romkk/TriDrone/doc/brushless_ctrl/umbauanleitung 18A sommer 2008/hinten.JPG

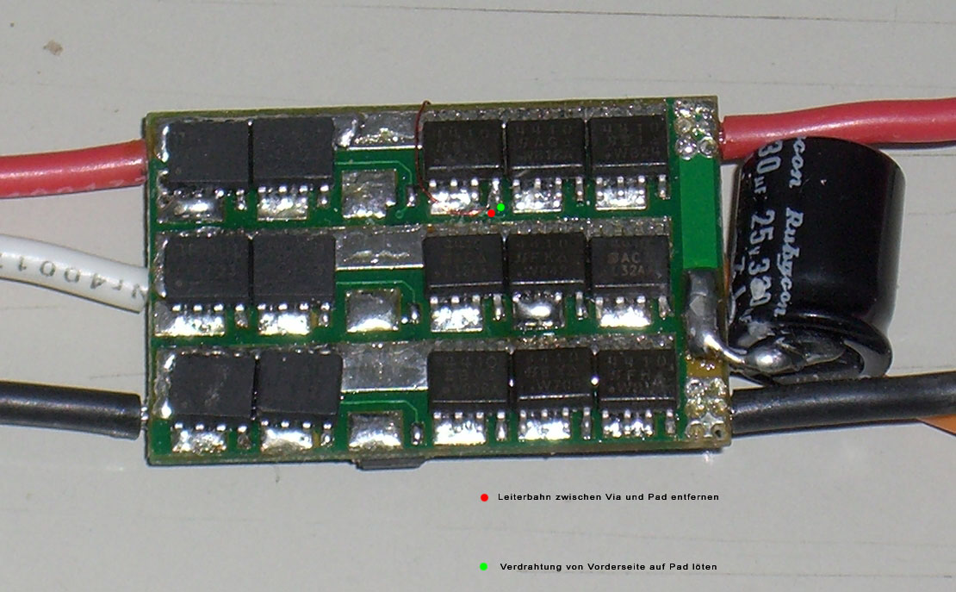
doc/brushless_ctrl/umbauanleitung 18A sommer 2008/hinten.JPG
