romkk/TriDrone/README.md

## About

Firmware and software collection of project "TriDrone".
It is a micro-copter project.
