romkk/TriDrone/doc/cockpit_mockup/telemetry_placeholder.jpg

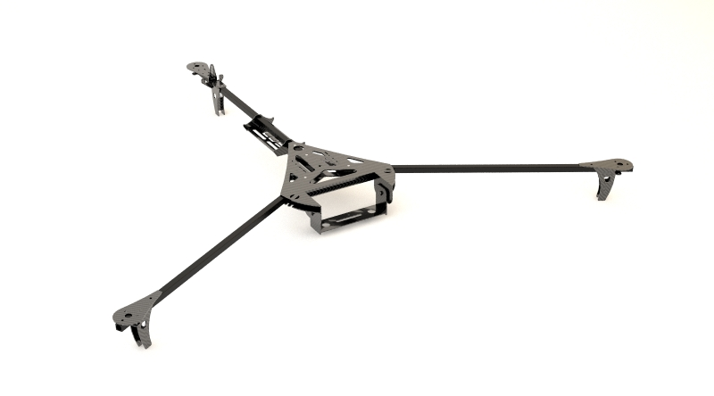
doc/cockpit_mockup/telemetry_placeholder.jpg
