romkk/TriDrone/doc/connectivity/img/ADXL322.jpeg

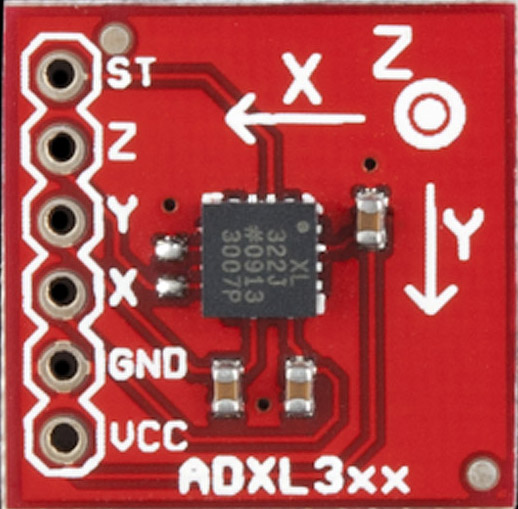
doc/connectivity/img/ADXL322.jpeg
