romkk/TriDrone/doc/connectivity/img/ArduinoProMini.jpg

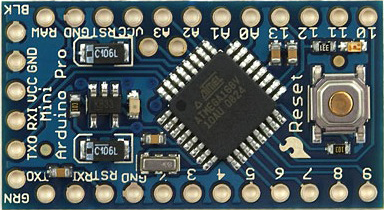
doc/connectivity/img/ArduinoProMini.jpg
