romkk/TriDrone/doc/connectivity/img/BL-Ctrl2_0.jpeg

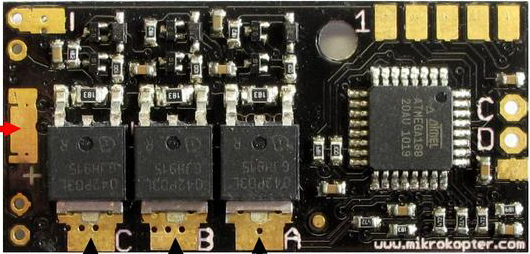
doc/connectivity/img/BL-Ctrl2_0.jpeg
