romkk/TriDrone/doc/connectivity/img/BMS-371.jpg

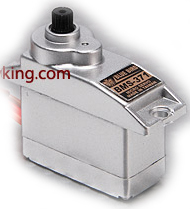
doc/connectivity/img/BMS-371.jpg
