romkk/TriDrone/doc/connectivity/img/ftdi_basic_breakout.jpg

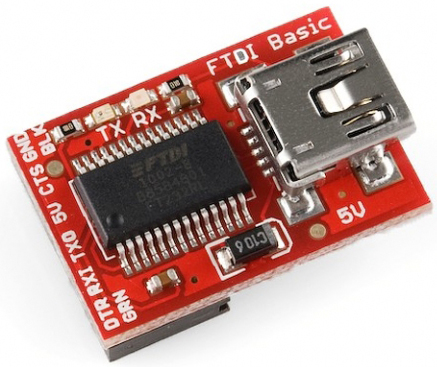
doc/connectivity/img/ftdi_basic_breakout.jpg
