romkk/TriDrone/doc/connectivity/img/Gyro_Breakout_Board_ADXRS610_300°_s.jpg

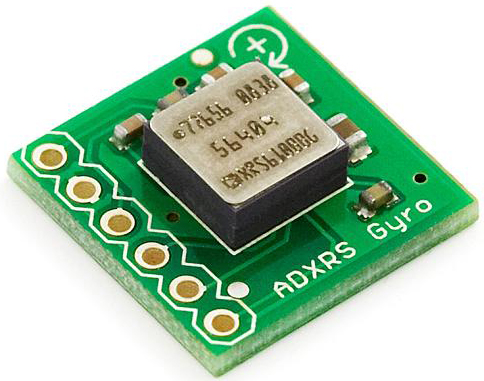
doc/connectivity/img/Gyro_Breakout_Board_ADXRS610_300°_s.jpg
