romkk/TriDrone/doc/connectivity/img/rockamp_2200mAh_3S_24.4Wh_30C.jpg

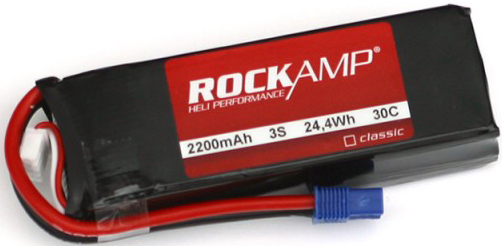
doc/connectivity/img/rockamp_2200mAh_3S_24.4Wh_30C.jpg
