romkk/TriDrone/doc/connectivity/img/SP_SII_2212_885.jpg

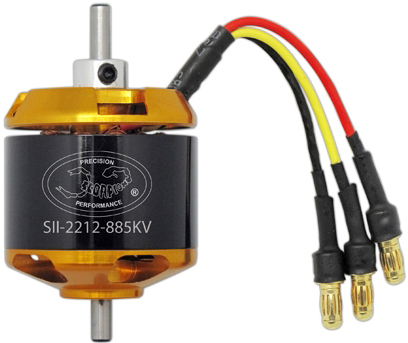
doc/connectivity/img/SP_SII_2212_885.jpg
