romkk/TriDrone/doc/connectivity/img/u_blox_module.jpg

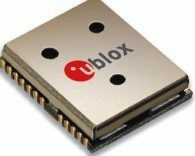
doc/connectivity/img/u_blox_module.jpg
