romkk/TriDrone/doc/connectivity/img/XBee Adapter Kit.jpg

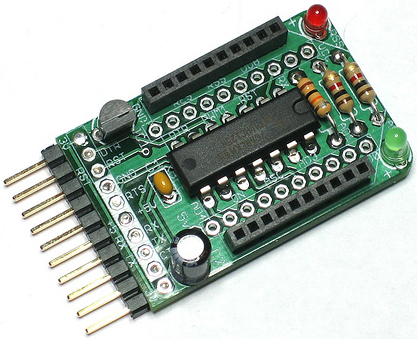
doc/connectivity/img/XBee Adapter Kit.jpg
