romkk/TriDrone/doc/connectivity/img/Xbee_series_2.jpg

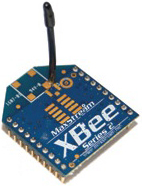
doc/connectivity/img/Xbee_series_2.jpg
