romkk/TriDrone/sch/Belichtungsreihe/Belichtungsreihe.png

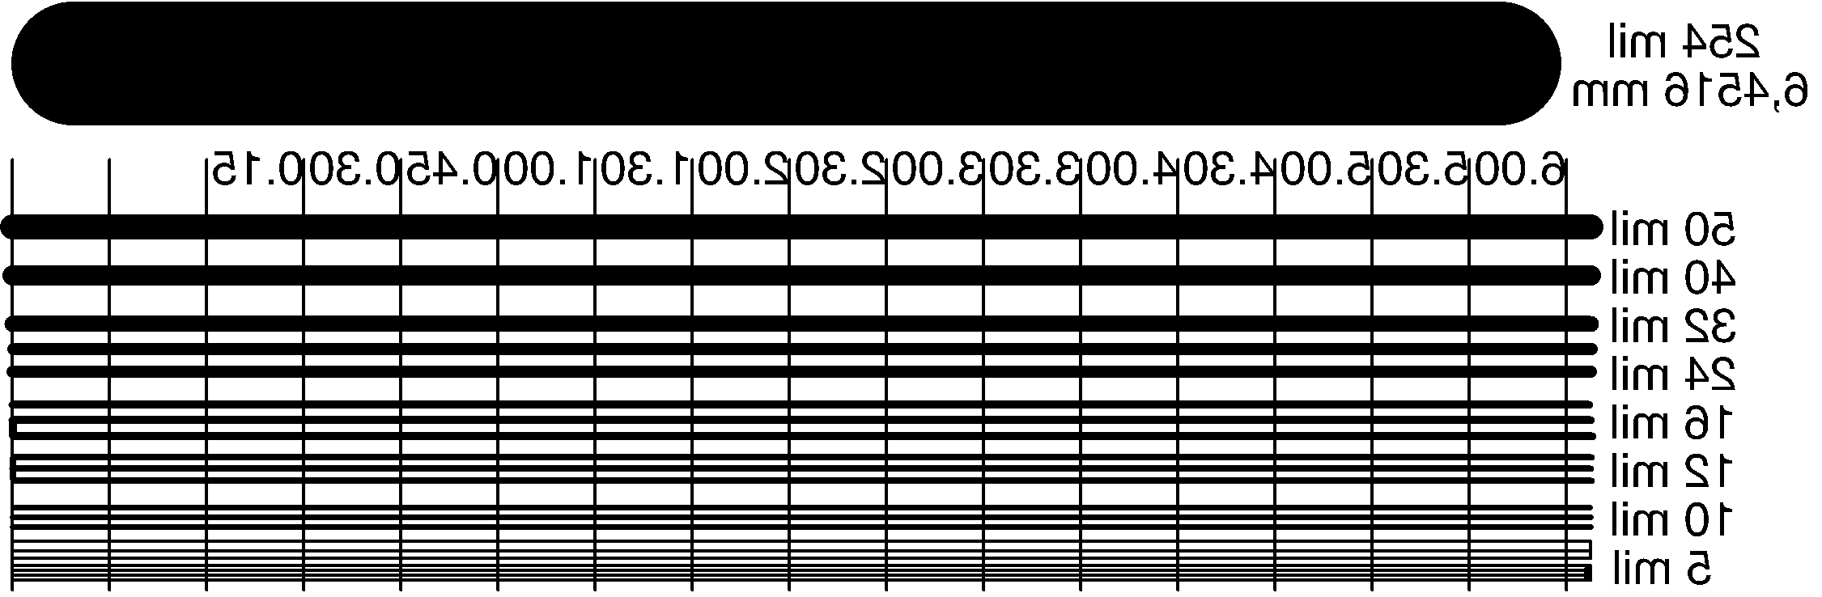
sch/Belichtungsreihe/Belichtungsreihe.png
