romkk/TriDrone/sch/TriDrone_2011.png

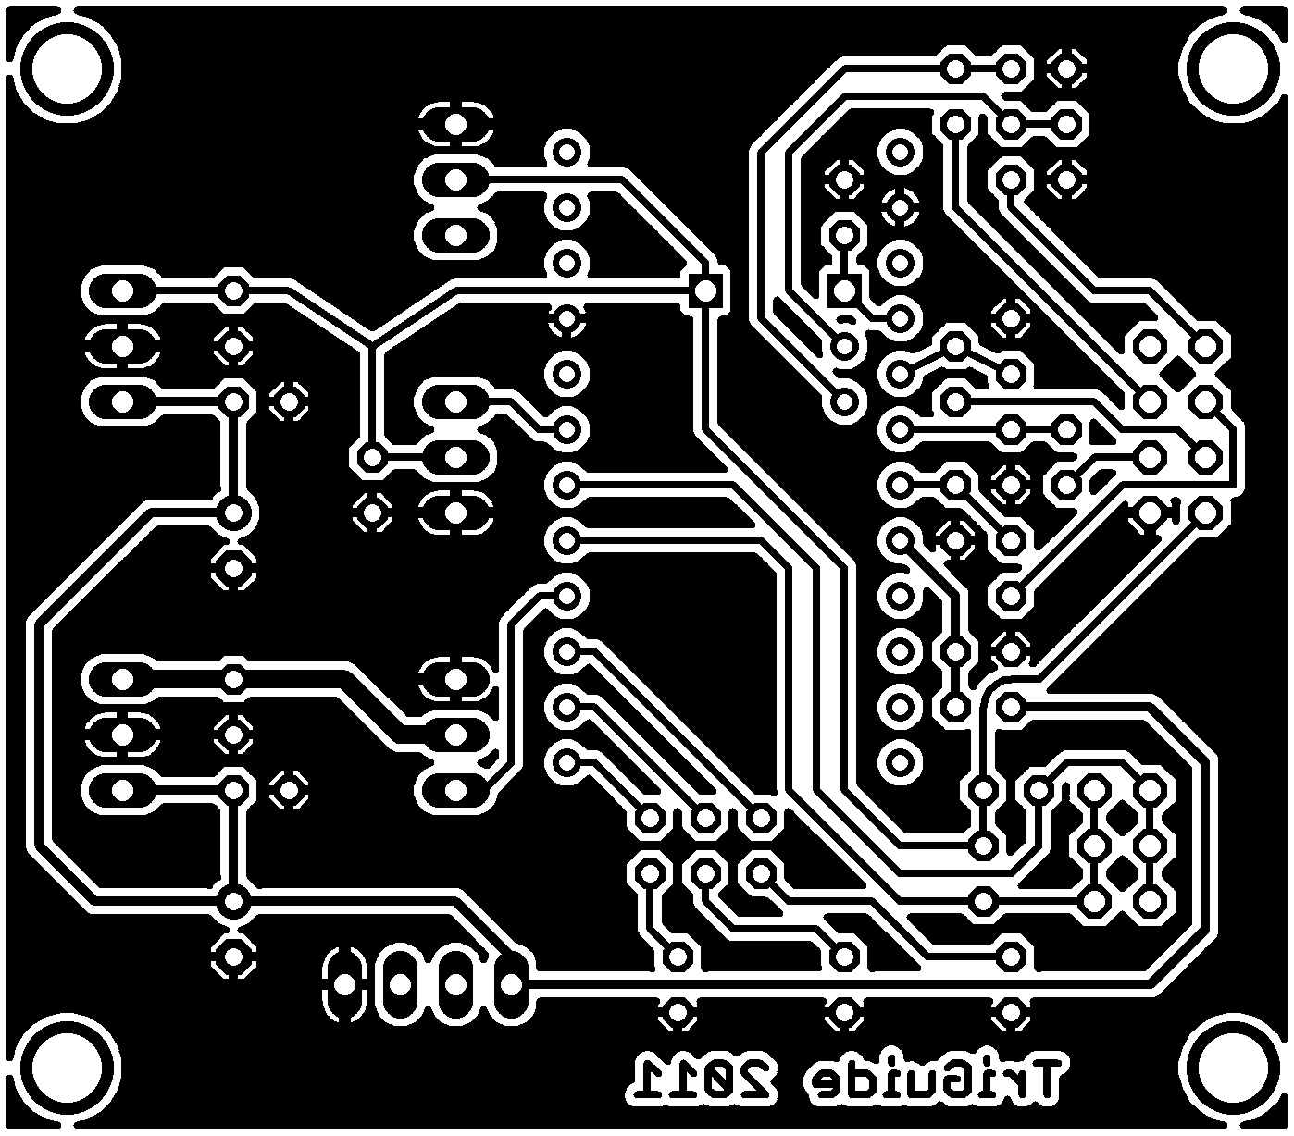
sch/TriDrone_2011.png
