romkk/TriDrone/sch/TriDrone_2012.png

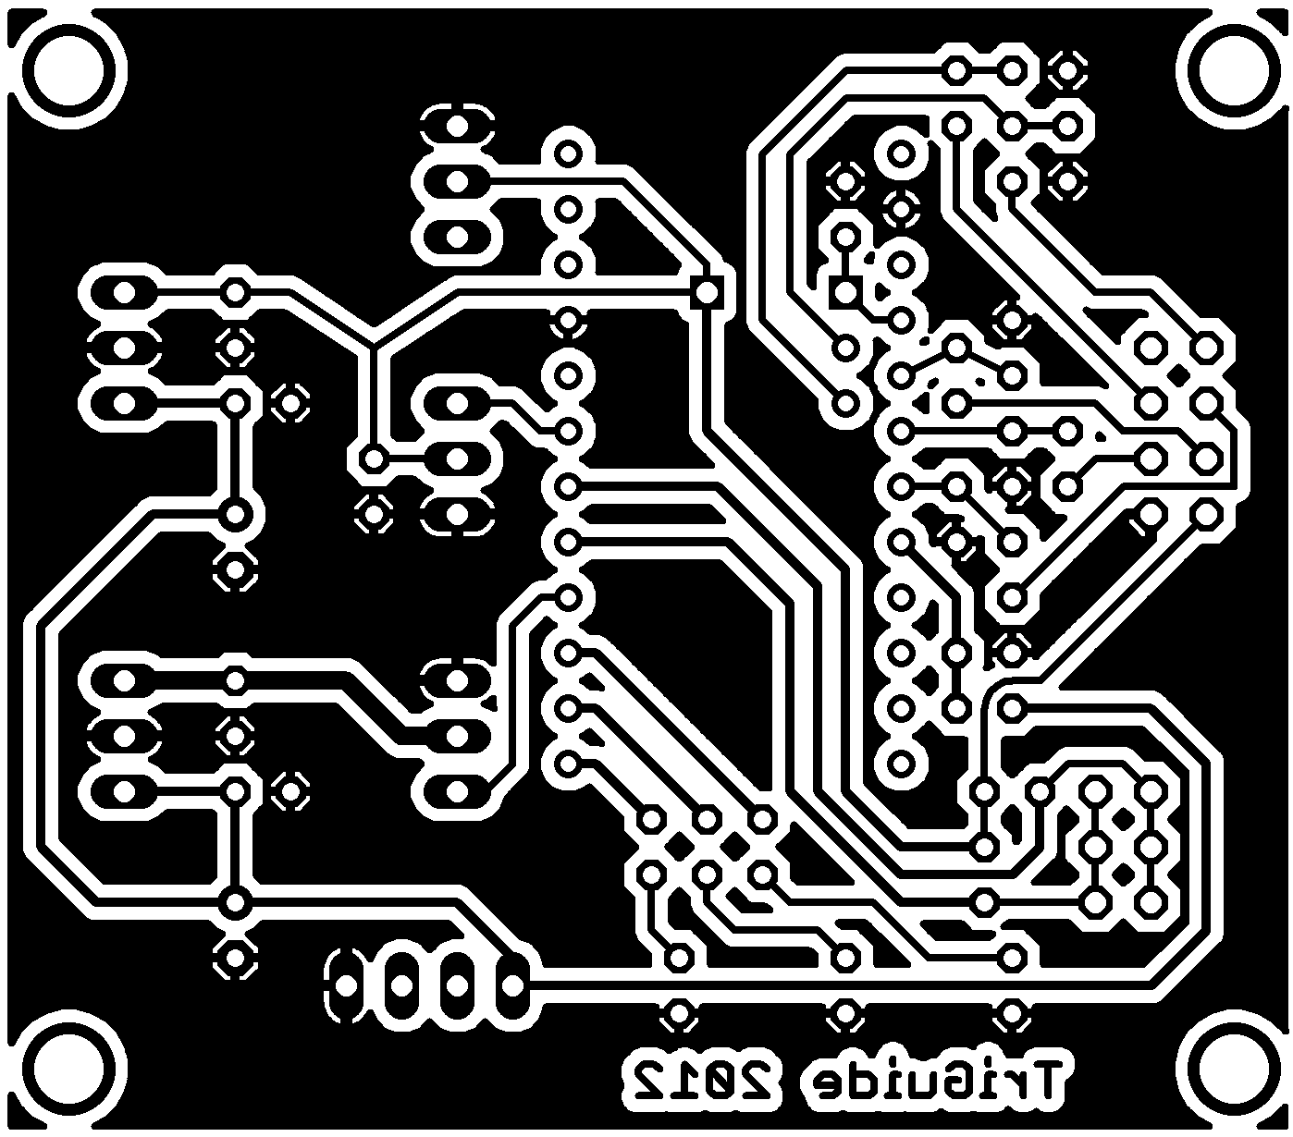
sch/TriDrone_2012.png
