romkk/TriDrone/doc/shopping_list/shopping_list.xls

Sheet: Export Summary
This document was exported from Numbers. Each table was converted to an Excel worksheet. All other objects on each Numbers sheet were placed on separate worksheets. Please be aware that formula calculations may differ in Excel.
Numbers Sheet Name | Numbers Table Name | Excel Worksheet Name
Sheet 1
 | Shopping list | Sheet 1 - Shopping list
Sheet 2
 | Kondensatoren | Sheet 2 - Kondensatoren
 | Widerstände | Sheet 2 - Widerstände
 | Transistoren | Sheet 2 - Transistoren

Sheet: Sheet 1 - Shopping list
Bezeichnung | Beschreibung | Anzahl | Einzelpreis | Preis | Shop
Arduino Pro Mini 328 - 5V/16MHz |  | 1 | €14.95 | €14.95 | watterott.com (http://www.watterott.com/de/Arduino-Pro-Mini-328-5V/16MHz)
Breakout Board - ADXL322 +/-2g |  | 1 | €24.90 | €24.90 | watterott.com (http://www.watterott.com/de/Breakout-Board-ADXL322)
Gyro Breakout Board - ADXRS610 - 300°/s |  | 3 | €54.74 | €164.22 | watterott.com (http://www.watterott.com/de/Gyro-Breakout-Board-ADXRS610-300/s)
FTDI Basic Breakout 5V |  | 1 | €11.90 | €11.90 | watterott.com (http://www.watterott.com/de/FTDI-Basic-Breakout-5V)
XBee 2mW Series 2.5 Wire Antenna |  | 2 | €25.00 | €50.00 | watterott.com (http://www.watterott.com/de/XBee-2mW-Series-25-Wire-Antenna)
Testkabel / Jumper Wires F/F 200mm |  | 2 | €2.75 | €5.50 | watterott.com (http://www.watterott.com/de/Testkabel-/-Jumper-Wires-F/F-200mm)
ROCKAMP 2200mAh 3S classic 30C mit EC3 |  | 2 | €33.95 | €67.90 | parkflieger.eu (http://www.parkflieger.eu/_detail_3574.html)
Scorpion SII-2212-885KV (V2) |  | 3 | €27.95 | €83.85 | parkflieger.eu (http://www.parkflieger.eu/_detail_3784.html)
Revolectrix CellPro Multi4S Balancer & Lader |  | 1 | €69.90 | €69.90 | parkflieger.eu (http://www.parkflieger.eu/_detail_1933.html)
Revolectrix CellPro USB Interface Modul FUIM2 |  | 1 | €12.90 | €12.90 | parkflieger.eu (http://www.parkflieger.eu/_detail_2351.html)
Revolectrix Netzteil 12V / 5A für 4S |  | 1 | €34.00 | €34.00 | akkuseite.de (http://www.akkuseite.de/product_info.php/info/p18478_Revolectrix--Netzteil-12V---5A-fuer-4S.html)
MaxxProducts EPP1045 | Propellerpaar 10x4,5” | 5 | €3.80 | €19.00 | cnc-modellsport.de (http://www.cnc-modellsport.de/product_info.php?cPath=36_118&products_id=885)
ALU-PROPSAVER für MaxxProd 3,00mm Welle |  | 5 | €3.30 | €16.50 | cnc-modellsport.de (http://www.cnc-modellsport.de/product_info.php?cPath=36_40&products_id=1439)
ACT-Empfänger “DSL-4ST” 35 MHz |  | 1 | €34.95 | €34.95 | conrad.de (http://www.conrad.de/ce/de/product/234088/ACT-EMPFAeNGER-DSL-4ST-35-MHZ)
TowerPro w18A Brushless Speed Controller |  | 4 | €9.00 | €36.00 | hobbyking.com (http://www.hobbyking.com/hobbyking/store/uh_viewItem.asp?idproduct=656)
Blue Bird BMS-371 Micro Precision Servo 1.5kg / .12sec / 8g |  | 2 | €8.00 | €16.00 | hobbyking.com (http://www.hobbyking.com/hobbyking/store/uh_viewItem.asp?idproduct=9444)
MAX 232 CPE | RS232-Driver, DIL-16 | 2 | €0.41 | €0.82 | reichelt.de (http://www.reichelt.de/?ACTION=3;ARTICLE=11216;PROVID=2402)
μA 7805 | Spannungsregler 1A positiv, TO-220 | 4 | €0.26 | €1.04 | reichelt.de (http://www.reichelt.de/?ACTION=3;ARTICLE=23443;PROVID=2402)
RAD FC 100/16 | Elko radial, 105°C, low ESR, RM 2,5mm | 10 | €0.10 | €1.00 | reichelt.de (http://www.reichelt.de/?ACTION=3;ARTICLE=84617;PROVID=2402)
X7R-2,5 100N | Vielschicht-Keramikkondensator 100N, 10% | 20 | €0.04 | €0.80 | reichelt.de (http://www.reichelt.de/?ACTION=3;ARTICLE=22853;PROVID=2402)
Z5U-5 1,0μ | Vielschicht-Keramikkondensator 1,0μ, 20% | 10 | €0.11 | €1.10 | reichelt.de (http://www.reichelt.de/?ACTION=3;ARTICLE=22985;PROVID=2402)
BC 548B | Transistor NPN TO-92 30V 0,1A 0,5W | 5 | €0.04 | €0.20 | reichelt.de (http://www.reichelt.de/?ACTION=3;ARTICLE=5009;PROVID=2402)
H25PR500 | Lochrasterplatine, Hartpapier, 500x100mm | 1 | €5.65 | €5.65 | reichelt.de (http://www.reichelt.de/?ACTION=3;ARTICLE=8274;PROVID=2402)
TANTAL 1,0/35 | Tantal-Kondensator, Rm 2,5, 1,0μF/35V | 5 | €0.14 | €0.70 | reichelt.de (http://www.reichelt.de/?ACTION=3;ARTICLE=20330;PROVID=2402)
SL 1X40G 2,54 | 40pol. Stiftleiste, gerade, RM 2,54 | 5 | €0.23 | €1.15 | reichelt.de (http://www.reichelt.de/?ACTION=3;ARTICLE=19506;PROVID=2402)
SL 1X40W 2,54 | 40pol. Stiftleiste, gewinkelt, RM 2,54 | 5 | €0.29 | €1.45 | reichelt.de (http://www.reichelt.de/?ACTION=3;ARTICLE=19507;PROVID=2402)
SL 2X40G 2,54 | 2x40pol. Stiftleiste, gerade, RM 2,54 | 5 | €0.27 | €1.35 | reichelt.de (http://www.reichelt.de/?ACTION=3;ARTICLE=19498;PROVID=2402)
SL 2X40W 2,54 | 2x40pol. Stiftleiste, gewinkelt, RM 2,54 | 5 | €0.36 | €1.80 | reichelt.de (http://www.reichelt.de/?ACTION=3;ARTICLE=19499;PROVID=2402)
Widerstand Metall 0,25W 1% 390R/100Stück |  | 1 | €2.21 | €2.21 | conrad.de (http://www.conrad.de/ce/de/product/408115/WIDERSTAND-METALL-025W-1-390R100STUeCK)
Widerstand Metall 0,25W 1% 5K1 /100Stück |  | 1 | €2.21 | €2.21 | conrad.de (http://www.conrad.de/ce/de/product/408719/WIDERSTAND-METALL-025W-1-5K1-100STUeCK/0241210)
Widerstand Metall 0,25W 1% 10K /100Stück |  | 1 | €2.21 | €2.21 | conrad.de (http://www.conrad.de/ce/de/product/408280/WIDERSTAND-METALL-025W-1-10K-100STUeCK)
Widerstand Metall 0,25W 1% 33K /100Stück |  | 1 | €2.21 | €2.21 | conrad.de (http://www.conrad.de/ce/de/product/408344/WIDERSTAND-METALL-025W-1-33K-100STUeCK)
Widerstand Metall 0,25W 1% 36K /100Stück |  | 1 | €2.21 | €2.21 | conrad.de (http://www.conrad.de/ce/de/product/409014/WIDERSTAND-METALL-025W-1-36K-100STUeCK)
Widerstand Metall 0,25W 1% 51K /100Stück |  | 1 | €2.21 | €2.21 | conrad.de (http://www.conrad.de/ce/de/product/409073/WIDERSTAND-METALL-025W-1-51K-100STUeCK)
Chassis |  | 0 |  | €0.00
 |  |  | Gesamtpreis | €692.79

Sheet: Sheet 2 - Kondensatoren
Kondensator | Kapazität | Spannung | Typ | Shop
C1 | 100 nF | ? | KERKO | reichelt
C2 | 100 nF | ? | KERKO | reichelt
C3 | 100 nF | ? | KERKO | reichelt
C4 | 100 μF | 16 V | ELKO (RAD) | reichelt
C5 | 1 μF | 25 V (35 V) | ELKO (Tantal) | reichelt
C6 | 1 μF | 25 V (35 V) | ELKO (Tantal) | reichelt
C7 | 1 μF | 25 V (35 V) | ELKO (Tantal) | reichelt
C8 | 100 nF | ? | KERKO | reichelt
C10 | 100 μF | 16 V | ELKO (RAD) | reichelt
C11 | 100 nF | ? | KERKO | reichelt
C12 | 100 nF | ? | KERKO | reichelt
C13 | 100 nF | ? | KERKO | reichelt
C14 | 100 nF | ? | KERKO | reichelt
C15 | 100 nF | ? | KERKO | reichelt
C16 | 1 μF | ? | KERKO | reichelt
C17 | 1 μF | ? | KERKO | reichelt
C18 | 100 nF | ? | KERKO | reichelt
C19 | 100 nF | ? | KERKO | reichelt
C34 | 1 μF | 25 V (35 V) | ELKO | reichelt

Sheet: Sheet 2 - Widerstände
Widerstand | Größe | Leistung | Typ | Shop
R1 | 5 kΩ | 0.25 W | Metall | conrad
R2 | 5 kΩ | 0.25 W | Metall | conrad
R3 | 51 kΩ | 0.25 W | Metall | conrad
R4 | 33 kΩ | 0.25 W | Metall | conrad
R5 | 36 kΩ | 0.25 W | Metall | conrad
R6 | 36 kΩ | 0.25 W | Metall | conrad
R7 | 36 kΩ | 0.25 W | Metall | conrad
R8 | 10 kΩ | 0.25 W | Metall | conrad
R9 | 10 kΩ | 0.25 W | Metall | conrad
R10 | 5 kΩ | 0.25 W | Metall | conrad
R11 | 5 kΩ | 0.25 W | Metall | conrad
R12 | 5 kΩ | 0.25 W | Metall | conrad
R13 | 390 Ω | 0.25 W | Metall | conrad
R14 | 390 Ω | 0.25 W | Metall | conrad
R15 | 390 Ω | 0.25 W | Metall | conrad

Sheet: Sheet 2 - Transistoren
Transistor | Typ | U_CEO | I_C | Gehäuse | Shop
T1 | BC 548 B | 30 V | 0.2 A | TO 92 | reichelt
T2 | BC 548 B | 30 V | 0.2 A | TO 92 | reichelt
T3 | BC 548 B | 30 V | 0.2 A | TO 92 | reichelt
