romkk/TriDrone/(list of files, cad)

Other CAD files:
doc/brushless_ctrl/umbauanleitung 18A sommer 2008/TP_18A_08_2008/bl-17a.obj
