romkk/TriDrone/doc/brushless_ctrl/umbauanleitung 18A sommer 2008/TowerPro25aOriginal.png

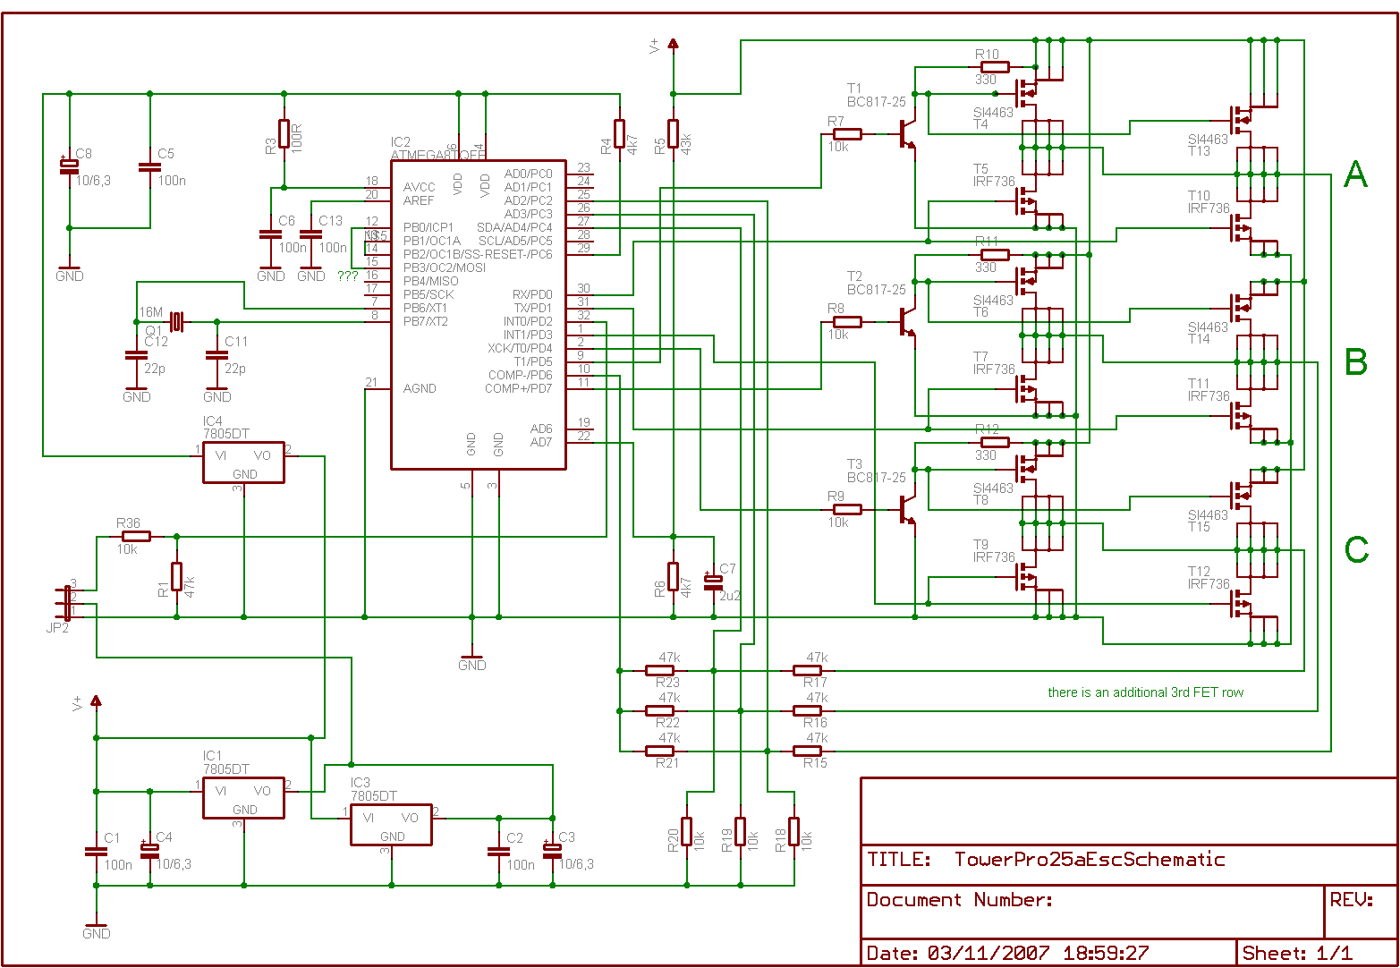
doc/brushless_ctrl/umbauanleitung 18A sommer 2008/TowerPro25aOriginal.png
