romkk/TriDrone/doc/brushless_ctrl/17a_schematic.pdf

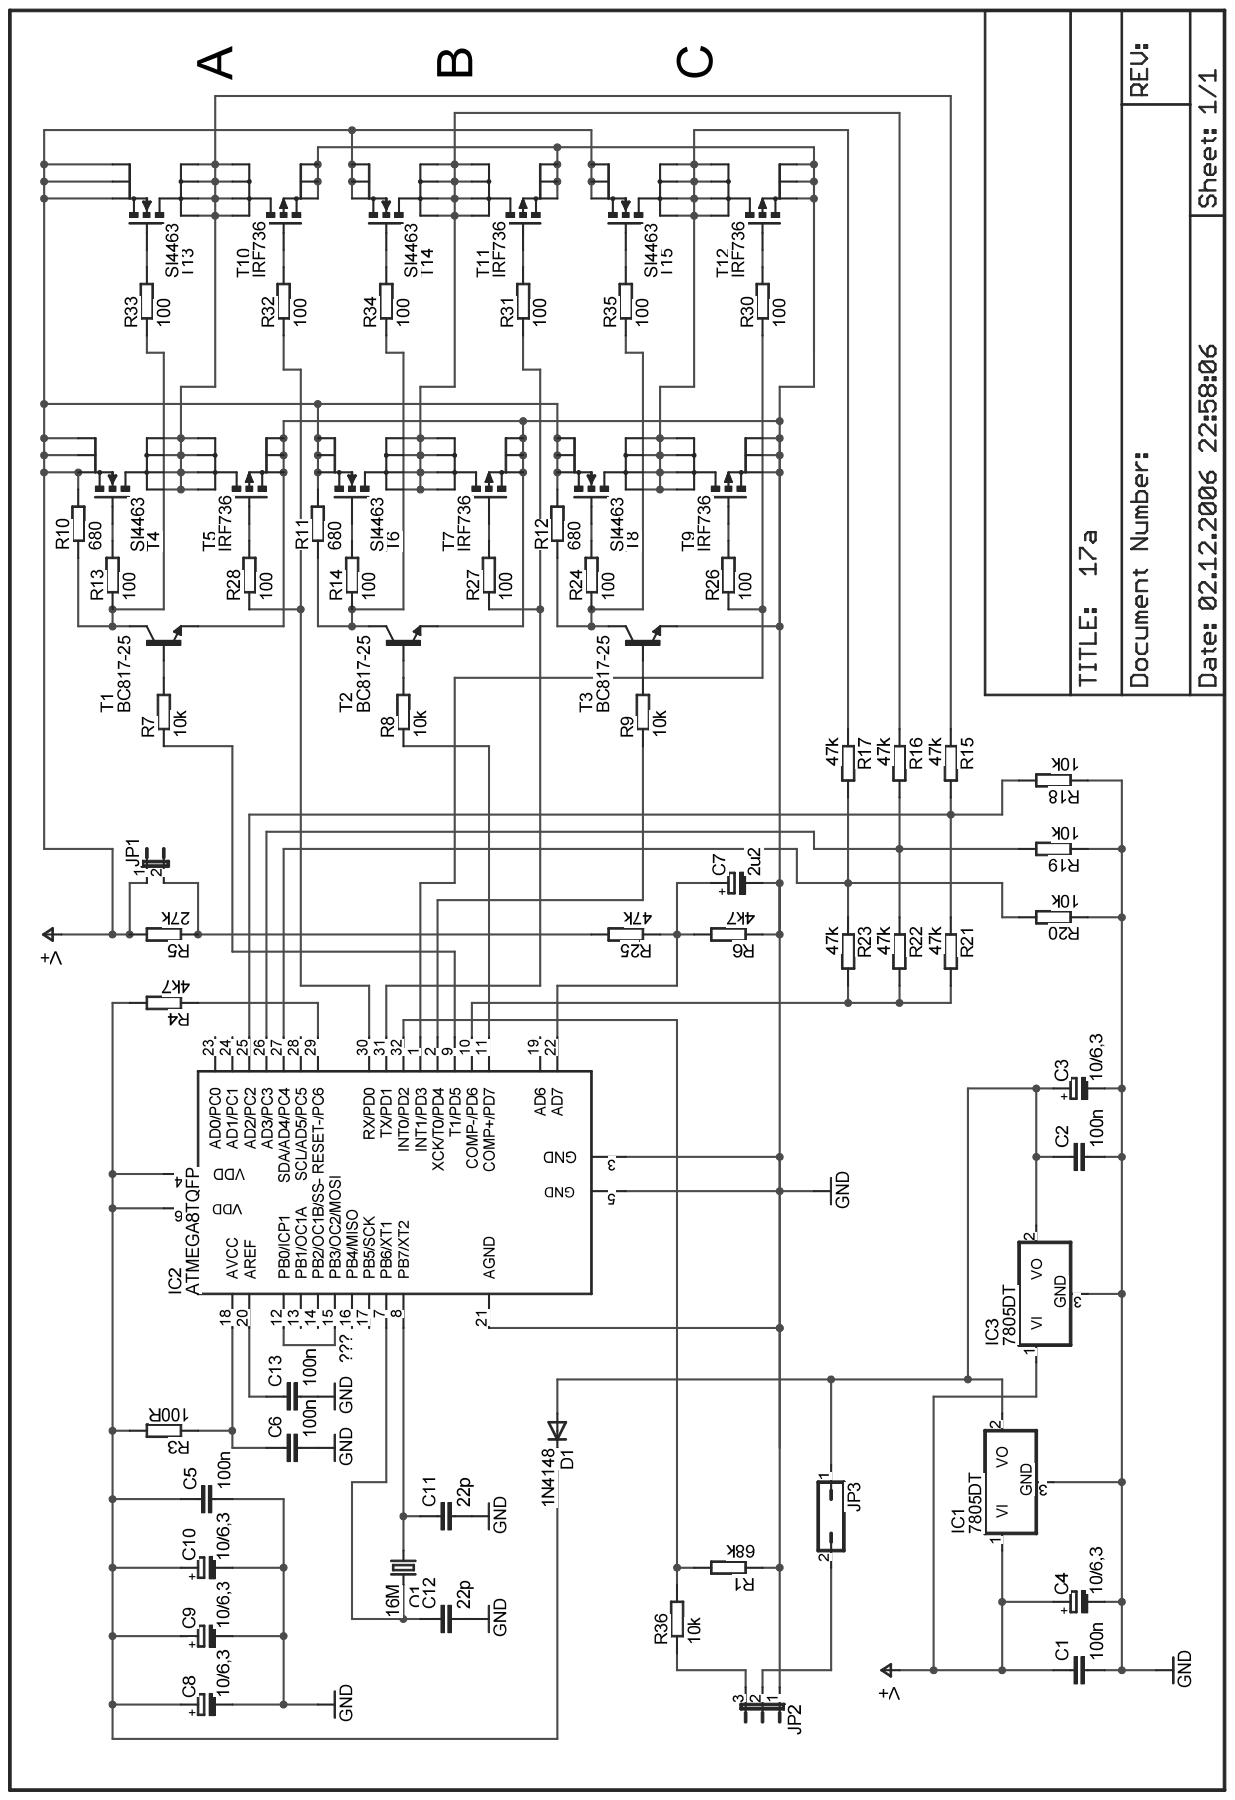
[picture p43: page 1]
