romkk/TriDrone/doc/brushless_ctrl/18a_tpro_schematic.pdf

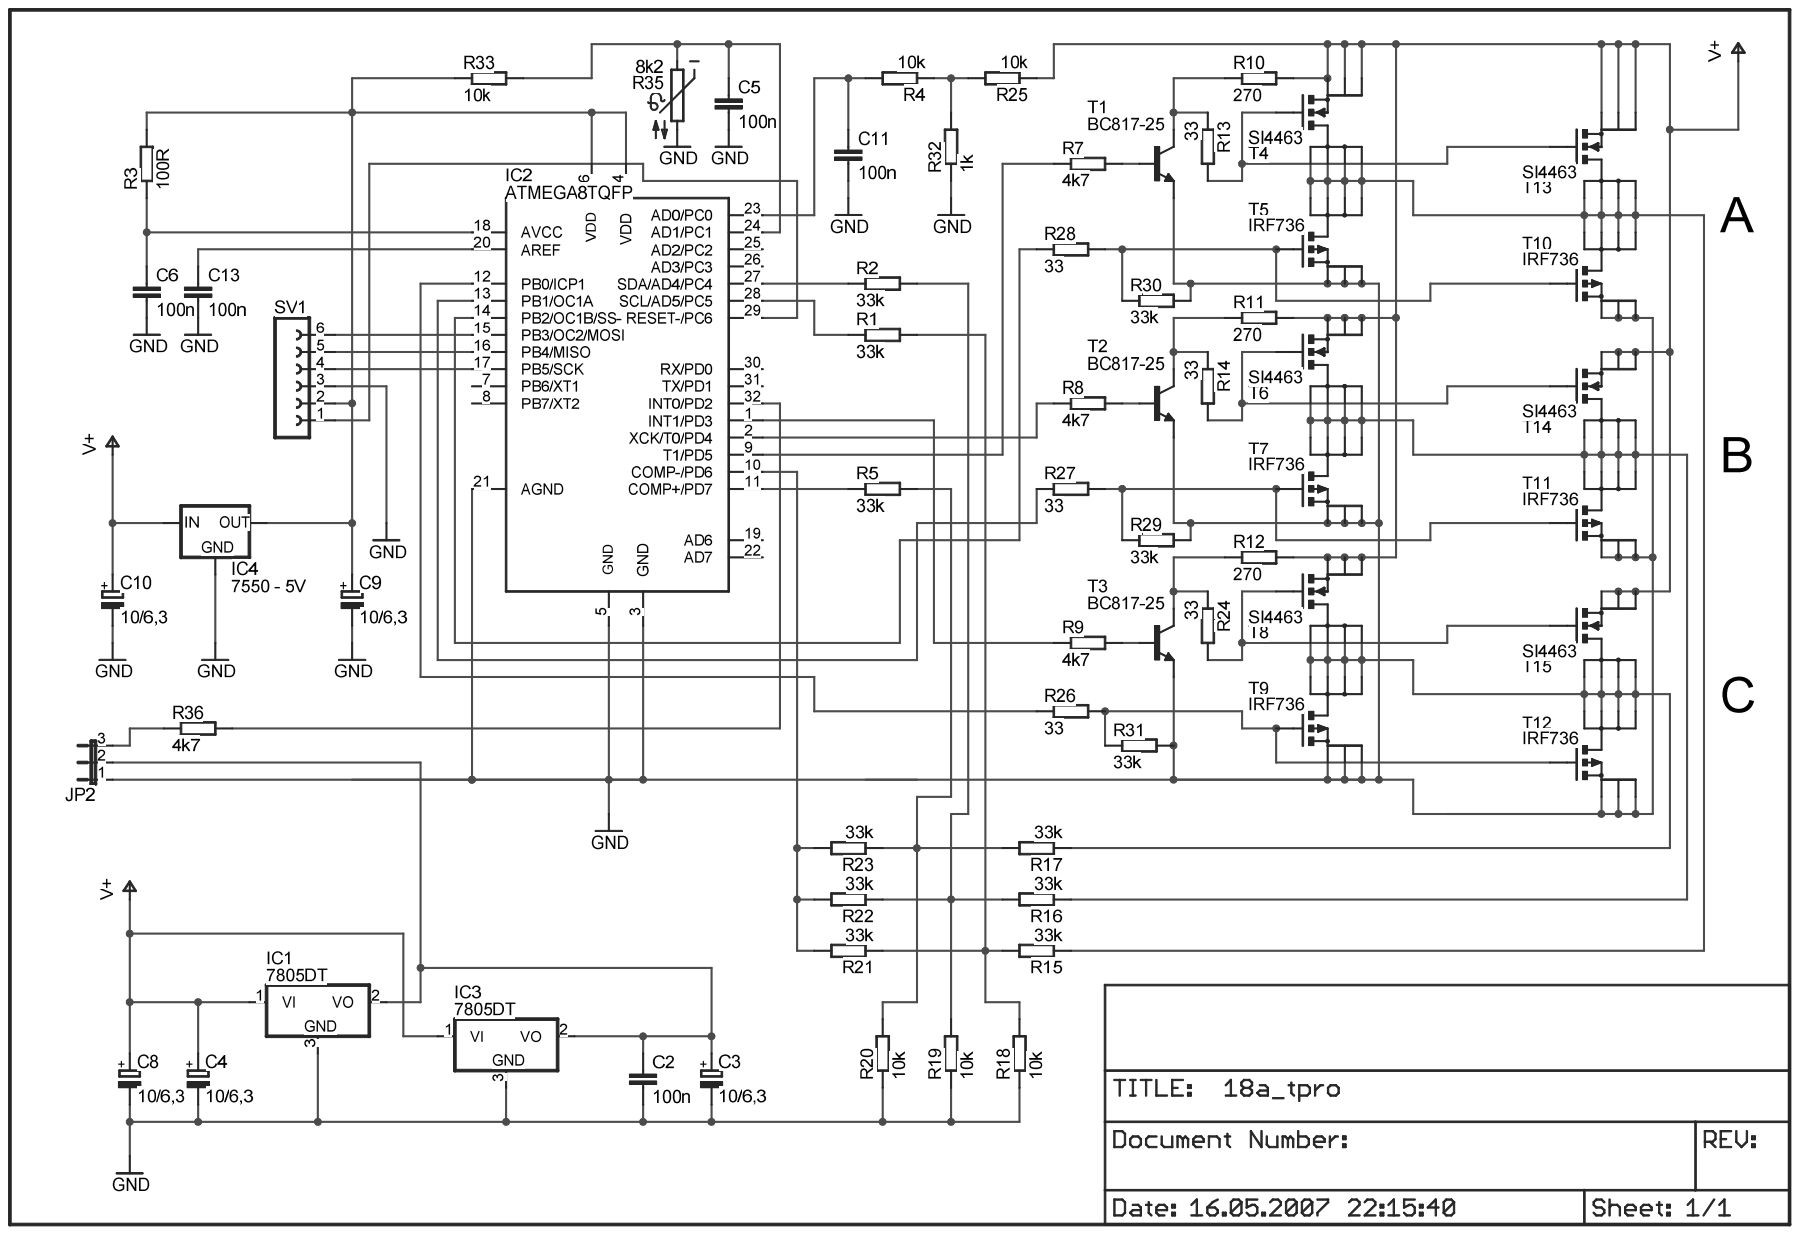
[picture p44: page 1]
