romkk/TriDrone/doc/brushless_ctrl/TowerPro 25A (HH30A_V1.1).brd

## EAGLE design doc/brushless_ctrl/TowerPro 25A (HH30A_V1.1).brd (2012-08-05)

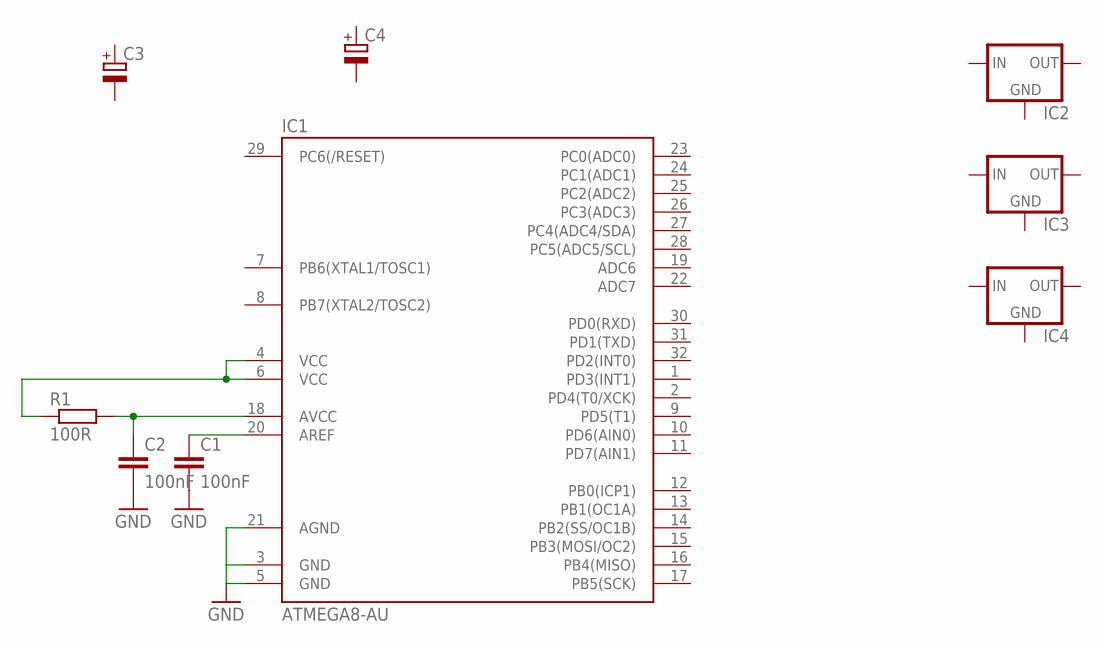
[picture p45: schematic TowerPro 25A (HH30A_V1.1).sch]

Parts:
C1, C2: 100nF; C2.5-3
C3, C4: CPOL-EUE3.5-10; E3,5-10
IC1: ATMEGA8-AU; TQFP32-08
IC2, IC3, IC4: 78MXXL
R1: 100R; M1206

Connections:
GND: C1.2, C2.2, IC1.3 (GND), IC1.5 (GND), IC1.21 (AGND)
unnamed: C1.1, IC1.20 (AREF)
unnamed: C2.1, IC1.18 (AVCC), R1.2
unnamed: IC1.4 (VCC), IC1.6 (VCC), R1.1

Board: 2 copper layers, 9 parts (0 on the bottom side), 4 nets, no tracks yet.
