romkk/TriDrone/sch/TriDrone_2012.brd

## EAGLE design sch/TriDrone_2012.brd (2012-08-05)

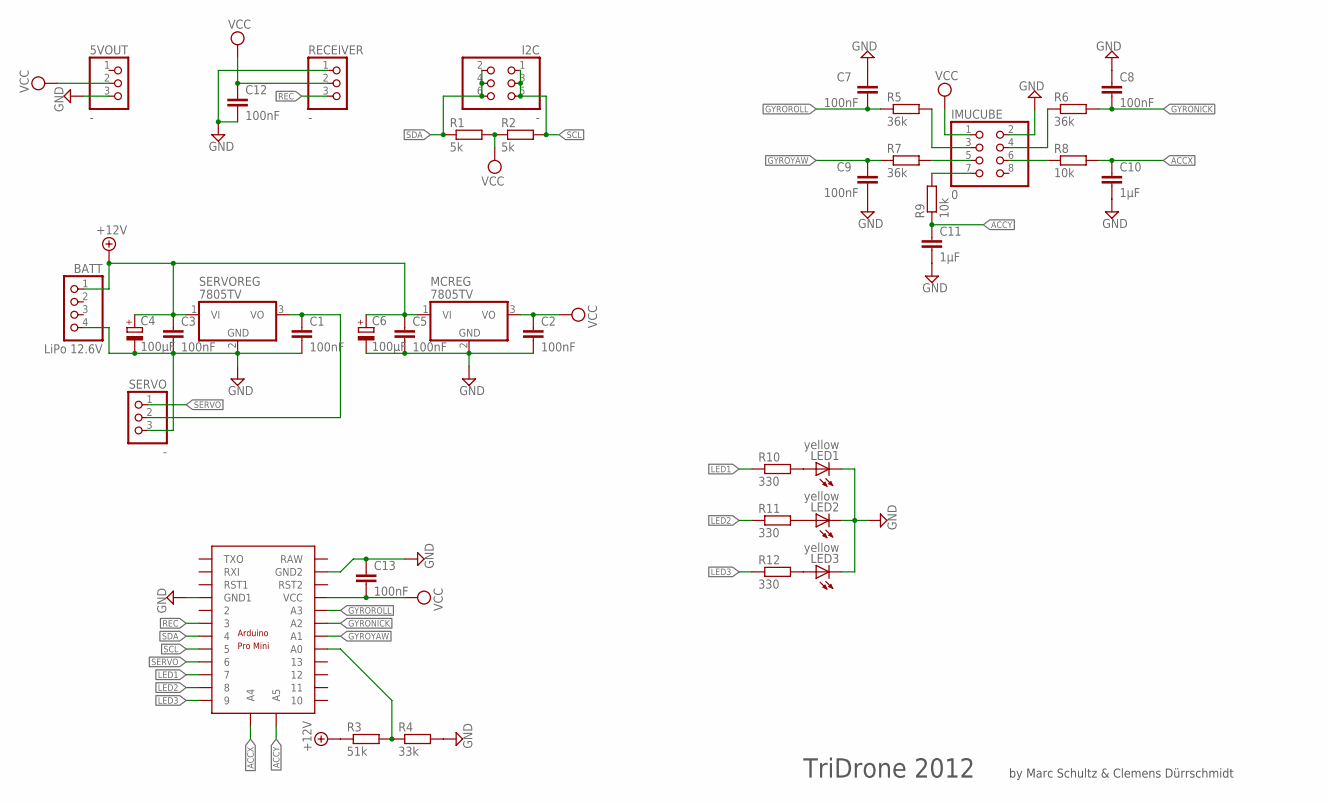
[picture p46: schematic TriDrone_2012.sch]

Parts:
5VOUT: -; 1X03
BATT: LiPo 12.6V; 1X04/90
C1, C2, C3, C5, C7, C8, C9, C12, C13: 100nF; C025-025X050
C4, C6: 100µF; E2,5-7
C10, C11: 1µF; C025-025X050
I2C: -; 2X03/90
IMUCUBE: 0; 2X04
LED1, LED2, LED3: yellow; LED3MM
MCREG: 7805TV; TO220V
R1, R2: 5k; 0204/7
R3: 51k; 0204/7
R4: 33k; 0204/7
R5, R6, R7: 36k; 0204/7
R8, R9: 10k; 0204/7
R10, R11, R12: 330; 0204/7
RECEIVER: -; 1X03
SERVO: -; 1X03
SERVOREG: 7805TV; TO220V
U$2: ARDUINO_PRO_MINI

Connections:
+12V: BATT.1, C3.1, C4.+, C5.1, C6.+, MCREG.1 (VI), R3.1, SERVOREG.1 (VI)
ACCX: C10.1, R8.2, U$2.A4
ACCY: C11.1, R9.1, U$2.A5
GND: 5VOUT.3, BATT.4, C1.2, C2.2, C3.2, C4.-, C5.2, C6.-, C7.1, C8.1, C9.2, C10.2, C11.2, C12.2, C13.1, IMUCUBE.2, LED1.K (C), LED2.K (C), LED3.K (C), MCREG.2 (GND), R4.2, RECEIVER.1, SERVO.3, SERVOREG.2 (GND), U$2.GND1, U$2.GND2
GYRONICK: C8.2, R6.2, U$2.A2
GYROROLL: C7.2, R5.1, U$2.A3
GYROYAW: C9.1, R7.1, U$2.A1
LED1: R10.1, U$2.7
LED2: R11.1, U$2.8
LED3: R12.1, U$2.9
unnamed: IMUCUBE.3, R5.2
unnamed: C1.1, SERVO.2, SERVOREG.3 (VO)
unnamed: IMUCUBE.4, R6.1
unnamed: R3.2, R4.1, U$2.A0
unnamed: IMUCUBE.6, R8.1
unnamed: IMUCUBE.5, R7.2
unnamed: IMUCUBE.7, R9.2
unnamed: LED1.A, R10.2
unnamed: LED2.A, R11.2
unnamed: LED3.A, R12.2
REC: RECEIVER.3, U$2.3
SCL: I2C.1, I2C.3, I2C.5, R2.2, U$2.5
SDA: I2C.2, I2C.4, I2C.6, R1.1, U$2.4
SERVO: SERVO.1, U$2.6
VCC: 5VOUT.2, C2.1, C12.1, C13.2, IMUCUBE.1, MCREG.3 (VO), R1.2, R2.1, RECEIVER.2, U$2.VCC

Notes on the sheet:
TriDrone 2012
by Marc Schultz & Clemens Dürrschmidt

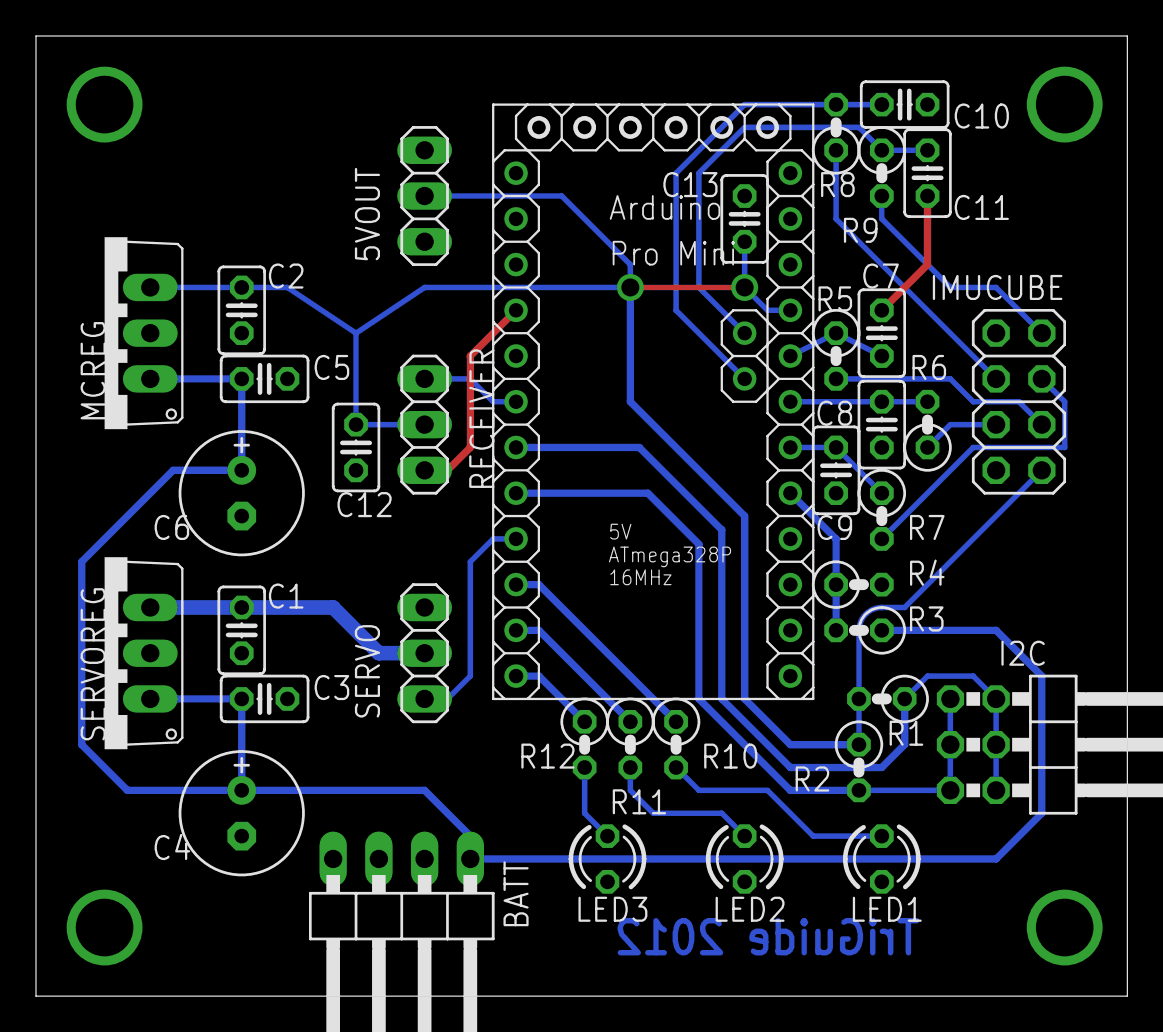
[picture p47: board TriDrone_2012.brd from above]

Board: 2 copper layers, 60.6 x 53.3 mm, 37 parts (0 on the bottom side), 25 nets.
