romkk/TriDrone/sch/TriDrone_mini_v1.brd

## EAGLE design sch/TriDrone_mini_v1.brd (2012-08-05)

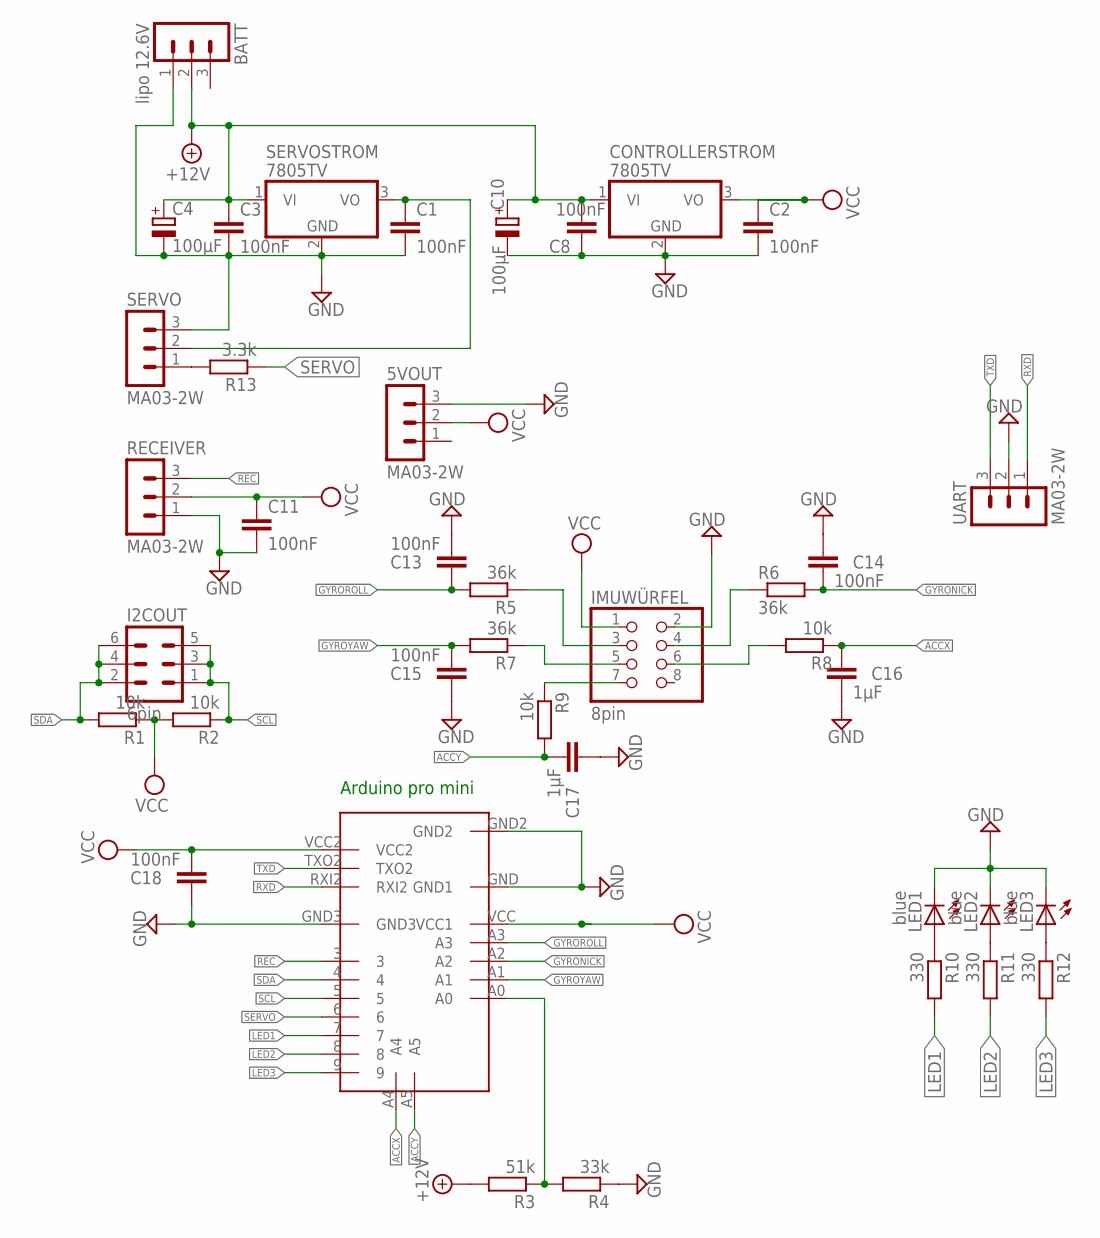
[picture p48: schematic TriDrone_mini_v1.sch]

Parts:
5VOUT: MA03-2W; MA03-1
BATT: lipo 12.6V; MA03-1
C1, C2, C3, C8, C11, C13, C14, C15, C18: 100nF; C1206
C4, C10: 100µF; D/7343-31W
C16, C17: 1µF; C1206
CONTROLLERSTROM: 7805TV; TO220V
I2COUT: 6pin; MA07-2W
IMUWÜRFEL: 8pin; 2X04
LED1, LED2, LED3: blue; LED3MM
R1, R2, R8, R9: 10k; R1206
R3: 51k; R1206
R4: 33k; R1206
R5, R6, R7: 36k; R1206
R10, R11, R12: 330; R1206
R13: 3.3k; R1206
RECEIVER: MA03-2W; MA03-1
SERVO: MA03-2W; MA03-1
SERVOSTROM: 7805TV; TO220V
U$1: ARDUINOMINIPRO; 1X12
UART: MA03-2W; MA03-1

Connections:
+12V: BATT.2, C3.1, C4.+, C8.2, C10.+, CONTROLLERSTROM.1 (VI), R3.2, SERVOSTROM.1 (VI)
ACCX: C16.1, R8.1, U$1.A4
ACCY: C17.2, R9.2, U$1.A5
GND: 5VOUT.3, BATT.1, C1.2, C2.2, C3.2, C4.-, C8.1, C10.-, C11.2, C13.2, C14.1, C15.1, C16.2, C17.1, C18.1, CONTROLLERSTROM.2 (GND), IMUWÜRFEL.2, LED1.K (C), LED2.K (C), LED3.K (C), R4.1, RECEIVER.1, SERVO.3, SERVOSTROM.2 (GND), U$1.GND (GND1), U$1.GND2, U$1.GND3, UART.2
GYRONICK: C14.2, R6.2, U$1.A2
GYROROLL: C13.1, R5.2, U$1.A3
GYROYAW: C15.2, R7.2, U$1.A1
LED1: R10.2, U$1.7
LED2: R11.2, U$1.8
LED3: R12.2, U$1.9
unnamed: LED1.A, R10.1
unnamed: LED2.A, R11.1
unnamed: IMUWÜRFEL.3, R5.1
unnamed: C1.1, SERVO.2, SERVOSTROM.3 (VO)
unnamed: LED3.A, R12.1
unnamed: R13.2, SERVO.1
unnamed: R3.1, R4.2, U$1.A0
unnamed: IMUWÜRFEL.4, R6.1
unnamed: IMUWÜRFEL.5, R7.1
unnamed: IMUWÜRFEL.6, R8.2
unnamed: IMUWÜRFEL.7, R9.1
REC: RECEIVER.3, U$1.3
RXD: U$1.RXI2, UART.1
SCL: I2COUT.1, I2COUT.3, I2COUT.5, R2.1, U$1.5
SDA: I2COUT.2, I2COUT.4, I2COUT.6, R1.2, U$1.4
SERVO: R13.1, U$1.6
TXD: U$1.TXO2, UART.3
VCC: 5VOUT.2, C2.1, C11.1, C18.2, CONTROLLERSTROM.3 (VO), IMUWÜRFEL.1, R1.1, R2.2, RECEIVER.2, U$1.VCC (VCC1), U$1.VCC2

Notes on the sheet:
Arduino pro mini

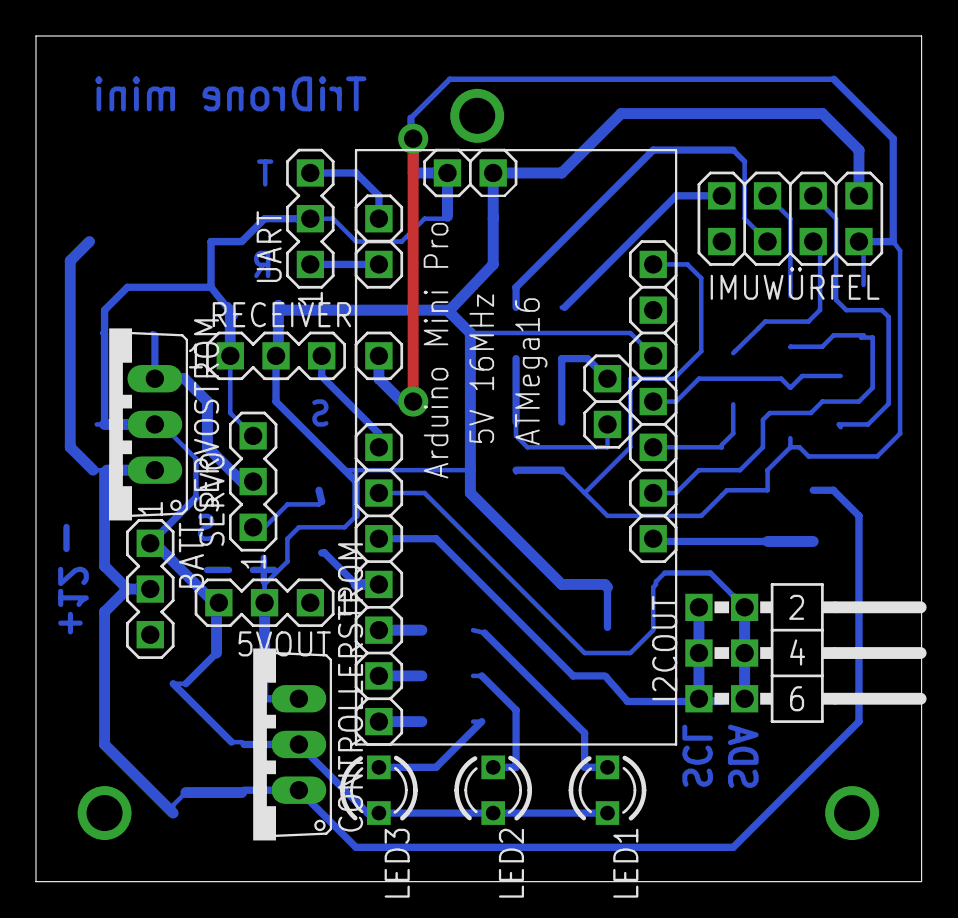
[picture p49: board TriDrone_mini_v1.brd from above]

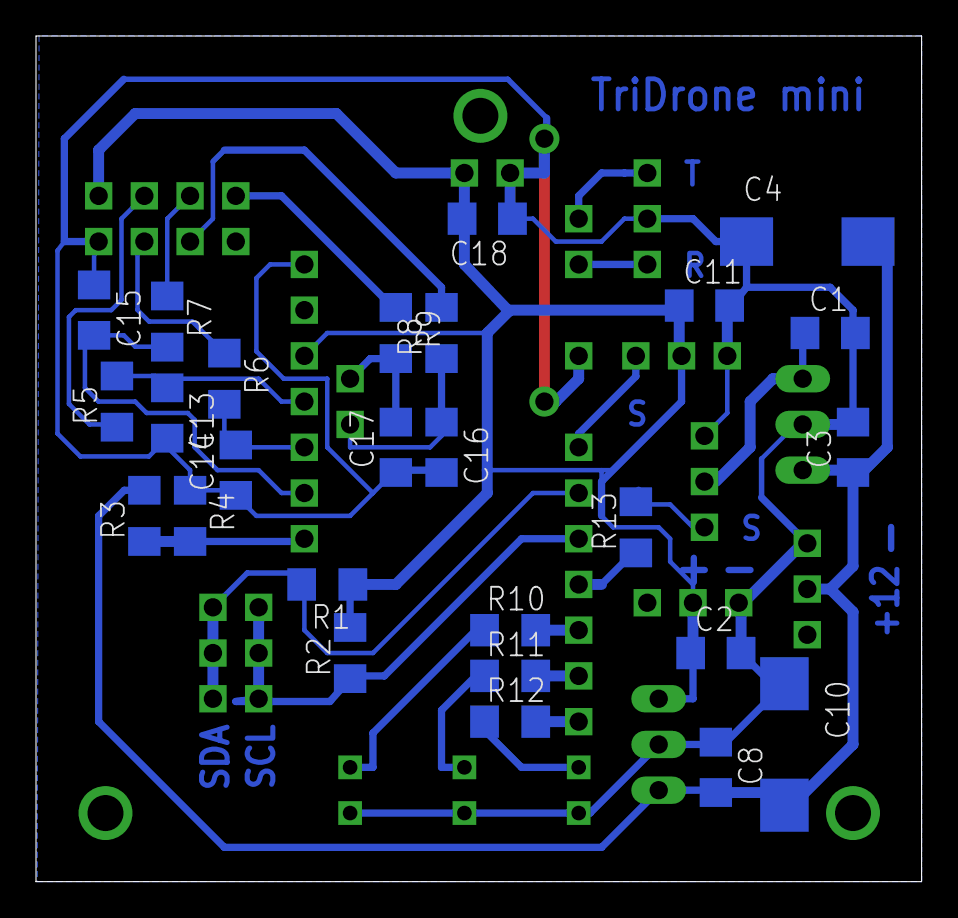
[picture p50: board TriDrone_mini_v1.brd from below]

Board: 2 copper layers, 49.2 x 47.0 mm, 39 parts (26 on the bottom side), 28 nets.
