romkk/TriDrone/firmware/src/i2c.h

unsigned char i2c_transmit(unsigned char type);
char i2c_start(unsigned int dev_id, unsigned int dev_addr, unsigned char rw_type);
void i2c_stop(void);
char i2c_write(char data);
char i2c_read(char *data,char ack_type);
void i2c_init(void);
