romkk/TriDrone/(commit log)

2012-08-05 ADD schematics
    [Belichtungsreihe.brd, TriDrone_2011.brd, TriDrone_2011.sch, TriDrone_2012.brd, TriDrone_2012.sch, TriDrone_mini_v1.brd, TriDrone_mini_v1.sch]
2012-08-05 ADD documentation files and datasheets
    [Arduino-Pro-Mini-v10.brd, Arduino-Pro-Mini-v10.sch, FTDI Basic-v21-5V.brd, FTDI Basic-v21-5V.sch, TowerPro 25A (HH30A_V1.1).brd, TowerPro 25A (HH30A_V1.1).sch, bl-17a.obj, shopping_list.xls]
2012-08-05 FIX location of firmware src
    [TriDrone_m328p.c, bits.c, i2c.c, i2c.h]
